pietroglyph/ferrofluid-display/README.md

# ferrofluid-display
Firmware, animation, and control code for a electromagnet-powered ferrofluid display.
