pietroglyph/ferrofluid-display/hardware/ecad/pcb-controller/pcb-controller.kicad_pcb

## KiCad design hardware/ecad/pcb-controller/pcb-controller.kicad_pcb (2021-11-19)

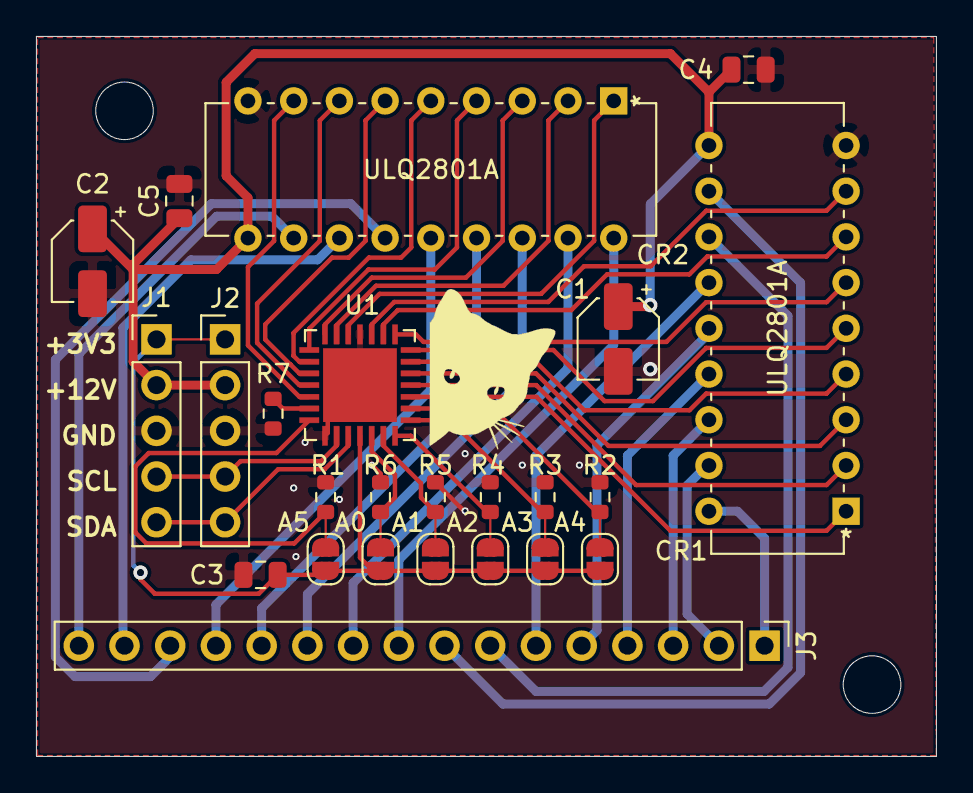
[picture p23: board pcb-controller.kicad_pcb from above]

Board: 2 copper layers, 50.0 x 40.0 mm, 26 parts (0 on the bottom side), 44 nets.

Parts:
A0, A1, A2, A3, A4, A5: SolderJumper_2_Open; SolderJumper-2_P1.3mm_Open_RoundedPad1.0x1.5mm
C1, C2: CP1; CP_Elec_4x5.4
C3, C4, C5: 0.1 uF; C_0805_2012Metric
CR1, CR2: ULQ2801A
H1, H2: MountingHole; MountingHole_3.2mm_M3
J1, J2: Conn_01x05; PinHeader_1x05_P2.54mm_Vertical
J3: Conn_01x16; PinHeader_1x16_P2.54mm_Vertical
R1, R2, R3, R4, R5, R6, R7: 10k; R_0603_1608Metric
U1: PCA9685BS; QFN65P600X600X100-29N

Connections:
+3V3: A0.1, A1.1, A2.1, A3.1, A4.1, A5.1, C3.1, J1.1, J2.1, U1.25
+12V: C1.1, C2.1, C4.1, C5.1, CR1.10, CR2.10, J1.2, J2.2
/A0: A0.2, R6.1, U1.26
/A1: A1.2, R5.1, U1.27
/A2: A2.2, R4.1, U1.28
/A3: A3.2, R3.1, U1.1
/A4: A4.2, R2.1, U1.2
/A5: A5.2, R1.1, U1.21
GND: C1.2, C2.2, C3.2, C4.2, C5.2, CR1.9, CR2.9, J1.3, J2.3, R1.2, R2.2, R3.2, R4.2, R5.2, R6.2, R7.2, U1.11, U1.22, U1.29
unnamed: CR1.1, U1.3
unnamed: CR1.2, U1.4
unnamed: CR1.3, U1.5
unnamed: CR1.4, U1.6
unnamed: CR1.5, U1.7
unnamed: CR1.6, U1.8
unnamed: CR1.7, U1.9
unnamed: CR1.8, U1.10
unnamed: CR1.11, J3.8
unnamed: CR1.12, J3.7
unnamed: CR1.13, J3.6
unnamed: CR1.14, J3.5
unnamed: CR1.15, J3.4
unnamed: CR1.16, J3.3
unnamed: CR1.17, J3.2
unnamed: CR1.18, J3.1
unnamed: CR2.1, U1.12
unnamed: CR2.2, U1.13
unnamed: CR2.3, U1.14
unnamed: CR2.4, U1.15
unnamed: CR2.5, U1.16
unnamed: CR2.6, U1.17
unnamed: CR2.7, U1.18
unnamed: CR2.8, U1.19
unnamed: CR2.11, J3.16
unnamed: CR2.12, J3.15
unnamed: CR2.13, J3.14
unnamed: CR2.14, J3.13
unnamed: CR2.15, J3.12
unnamed: CR2.16, J3.11
unnamed: CR2.17, J3.10
unnamed: CR2.18, J3.9
unnamed: J1.4, J2.4, U1.23
unnamed: J1.5, J2.5, U1.24
unnamed: R7.1, U1.20
