pietroglyph/ferrofluid-display/firmware/toggle_magnet/toggle_magnet.ino

// TO COMPILE:
// 1. Install avr_stl via the arduino IDE library manager
// 2. Go to Tools/Board/Boards Manager and set Arduino AVR version to 1.8.2
//    (See this thread on ArduinoSTL:
//    https://github.com/mike-matera/ArduinoSTL/issues/56
// 3. You need to increase SERIAL_RX_BUFFER_SIZE; because our file is
//    preprocessed in a way that adds #include <Arduino.h> at the start, any
//    definition of that macro will have no effect. You will need to edit
//    https://github.com/arduino/ArduinoCore-avr/blob/6154b7a7c1fba34737562aa4c29cec7451a82989/cores/arduino/HardwareSerial.h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
//    to use a buffer size of 256 manually.

#ifdef __AVR_ARCH__
#include "ArduinoSTL.h"
#endif

#include <cstddef>
#include <cstdint>

#include <algorithm>
#include <array>

#include <Arduino.h>
#ifdef __AVR_ARCH__
#undef min
#undef max
#endif

#include <Adafruit_PWMServoDriver.h>
#include <SdFat.h>

#ifdef __AVR_ARCH__
constexpr bool IS_TEENSY = false;
#else
constexpr bool IS_TEENSY = true;
#endif

constexpr std::uint8_t COLS_OF_BOARDS = 1, ROWS_OF_BOARDS = 1;
constexpr std::uint8_t NUM_BOARDS = COLS_OF_BOARDS * ROWS_OF_BOARDS;

constexpr std::uint8_t COLS_OF_MAGNETS = 4, ROWS_OF_MAGNETS = 4;
constexpr std::uint8_t NUM_MAGNETS_PER_BOARD =
    COLS_OF_MAGNETS * ROWS_OF_MAGNETS;
constexpr std::uint8_t NUM_MAGNETS = NUM_BOARDS * NUM_MAGNETS_PER_BOARD;

// Maxiumum magnet duty cycle; out of 4095 for the PCA
constexpr std::uint16_t MAX_DUTY_CYCLE = 4095;

// I^2C base address for boards (boards are assumed to be at addresses
// increasing sequentially from tihs address)
constexpr std::uint8_t BOARDS_ID_BASE = 0x42;

// CS pin for SD card reading on SPI
constexpr std::uint8_t CHIPSELECT_PIN = SS;

std::array<Adafruit_PWMServoDriver *, NUM_BOARDS> drivers;
SdFs sd;
FsFile animation_file;

void drive_output(std::uint8_t magnet_idx, std::uint16_t duty_cycle) {
  const std::uint8_t board_idx = magnet_idx / NUM_MAGNETS_PER_BOARD;
  // Need to subtract here because images start from top left indexes
  const std::uint8_t local_magnet_idx = magnet_idx % NUM_MAGNETS_PER_BOARD;

  // Serial.printf("Writing %d duty cycle to local magnet idx %d on board %d\n",
  // duty_cycle, local_magnet_idx, board_idx);

  drivers[board_idx]->setPin(local_magnet_idx, duty_cycle);
}

void drive_output(std::uint8_t x_coord, std::uint8_t y_coord,
                  std::uint16_t duty_cycle) {
  // Convert coordinate to board and magnet number
  // Assumes board 0 is in bottom left, and boards are
  // numbered going right and up (row major)
  const std::uint8_t board_x = x_coord / COLS_OF_MAGNETS;
  const std::uint8_t board_y = y_coord / ROWS_OF_MAGNETS;

  const std::uint8_t board_idx = board_x + board_y * COLS_OF_BOARDS;

  const std::uint8_t magnet_x = x_coord % COLS_OF_MAGNETS;
  const std::uint8_t magnet_y = y_coord % ROWS_OF_MAGNETS;

  const std::uint8_t magnet_idx = magnet_x + magnet_y * COLS_OF_MAGNETS;

  drivers[board_idx]->setPin(magnet_idx, duty_cycle);
}

// Returns true if the SD card is ok or false otherwise
bool try_open_sd() {
  if (!sd.sdErrorCode())
    return true;

  Serial.println(String("Opening SD card ") +
                 (IS_TEENSY ? "via SDIO" : "via SPI in Default mode"));
  bool ok;
  if constexpr (IS_TEENSY) {
    const SdSpiConfig spi_config{CHIPSELECT_PIN, DEDICATED_SPI, SPI_HALF_SPEED};
    ok = sd.begin(spi_config);
  } else {
    const auto sd_config = FIFO_SDIO;
    ok = sd.begin(sd_config);
  }
  if (!ok) {
    Serial.println("Failed to open SD card");
    return false;
  }
  return true;
}

class discrete_driver {
public:
  discrete_driver(unsigned long frame_period) : frame_period{frame_period} {}

  void set_magnet(std::uint8_t magnet_idx, std::uint16_t duty_cycle) {
    duty_cycles_current[magnet_idx] = duty_cycle;
  }

  bool ready_for_new_frame() { return ready_for_frame; }

  void update_display() {
    if (millis() - last_frame_time >= frame_period) {
      for (std::size_t i = 0; i < NUM_MAGNETS; i++) {
        drive_output(i, duty_cycles_current[i]);
      }

      ready_for_frame = true;
      last_frame_time = millis();
    } else
      ready_for_frame = false;
  }

protected:
  unsigned long frame_period;
  
  std::array<std::uint16_t, NUM_MAGNETS> duty_cycles_current{};
  unsigned long last_frame_time = 0;
  bool ready_for_frame = true;
};

class interpolating_driver : public discrete_driver {
public:
  interpolating_driver(unsigned long frame_period)
      : discrete_driver{frame_period} {}

  // User is expected to set all values, or array contents might be undefined or
  // previous values
  void set_magnet(std::uint8_t magnet_idx, std::uint16_t duty_cycle) {
    duty_cycles_next[magnet_idx] = duty_cycle;
  }

  bool ready_for_new_frame() { return ready_for_frame; }

  void update_display() {
    if (millis() - last_frame_time >= frame_period) {
      std::copy(duty_cycles_current.begin(), duty_cycles_current.end(),
                duty_cycles_last.begin());
      std::copy(duty_cycles_next.begin(), duty_cycles_next.end(),
                duty_cycles_current.begin());

      //        for (size_t i = 0; i < NUM_MAGNETS; i++) {
      //          Serial.printf("cur[%d]: %d, last[%d]: %d, next[%d]: %d\n", i,
      //          duty_cycles_current[i], i, duty_cycles_last[i], i,
      //          duty_cycles_next[i]);
      //        }

      ready_for_frame = true;
      last_frame_time = millis();
    } else {
      ready_for_frame = false;
    }

    for (std::size_t i = 0; i < NUM_MAGNETS; i++) {
      std::uint16_t slerped =
          duty_cycles_current[i] +
          std::max(static_cast<std::int32_t>(duty_cycles_last[i]) -
                       static_cast<std::int32_t>(duty_cycles_current[i]),
                   static_cast<std::int32_t>(0)) *
              (1.0 -
               static_cast<double>(millis() - last_frame_time) / frame_period);
      drive_output(i, slerped);
    }
  }

private:
  std::array<std::uint16_t, NUM_MAGNETS> duty_cycles_next{};
  std::array<std::uint16_t, NUM_MAGNETS> duty_cycles_last{};
};

enum control_mode {
  manual,
  sd_card,
  serial,
  off,
};
control_mode mode = control_mode::manual;
auto driver = interpolating_driver{1750};
boolean looping = false;

void setup() {
  Serial.begin(115200);

  Serial.println("Connecting to servo boards:");
  for (std::size_t i = 0; i < NUM_BOARDS; i++) {
    Serial.print("\tConnecting to board ");
    Serial.println(BOARDS_ID_BASE + i);
    drivers[i] = new Adafruit_PWMServoDriver(BOARDS_ID_BASE + i);
    drivers[i]->begin();
    drivers[i]->setOutputMode(true);
  }
  Serial.println("Servo boards connected");

  try_open_sd();
}

void loop() {
  if (Serial.available() && mode != control_mode::serial) {
    const auto command = Serial.readStringUntil(':');
    if (command == "XY") {
      mode = control_mode::manual;

      const int x = Serial.parseInt();
      Serial.find(',');
      const int y = Serial.parseInt();
      Serial.find(',');
      const int duty_cycle = Serial.parseInt();
      drive_output(x, y,
                   std::min(std::max(duty_cycle, 0),
                            static_cast<decltype(duty_cycle)>(MAX_DUTY_CYCLE)));

      Serial.println("Toggling magnet at position (" + (String)x + ", " + y +
                     "), with duty cycle " + duty_cycle);
    } else if (command == "IDX") {
      mode = control_mode::manual;

      const int idx = Serial.parseInt();
      Serial.find(',');
      const int duty_cycle = Serial.parseInt();

      drive_output(idx,
                   std::min(std::max(duty_cycle, 0),
                            static_cast<decltype(duty_cycle)>(MAX_DUTY_CYCLE)));
    } else if (command == "OFF") {
      mode = control_mode::off;
    } else if (command == "ls") {
      if (!try_open_sd()) {
        return;
      }
      sd.ls("/", LS_DATE | LS_SIZE | LS_R);
    } else if (command == "SD") {
      if (!try_open_sd()) {
        mode = control_mode::off;
        return;
      }

      mode = control_mode::sd_card;
      const String file_name = Serial.readStringUntil('\n');
      Serial.println("Opening file " + file_name);

      bool ok;
      if (!animation_file.open(file_name.c_str(), O_RDONLY)) {
        Serial.print("Failed to open file; failure code: ");
        sd.errorPrint(&Serial);
        Serial.println("\n Defaulting to first file on SD");
        
        FsFile root_dir;
        root_dir.open("/");
        ok = animation_file.openNext(&root_dir, O_RDONLY);
      }
      if (!ok) {
        Serial.println("Couldn't open file; does it exist?");
        mode = control_mode::off;
        return;
      }

      const int magnet_rows = animation_file.parseInt();
      if (animation_file.read() != ',') {
        Serial.println("Malformed separator");
        mode = control_mode::off;
        return;
      }
      const int magnet_cols = animation_file.parseInt();

      if (magnet_rows != ROWS_OF_MAGNETS || magnet_cols != COLS_OF_MAGNETS) {
        Serial.println("Mismatched number of magnets per row or column");
        mode = control_mode::off;
        return;
      }

      Serial.println("Running animation '" + file_name + "' for " +
                     magnet_cols + "x" + magnet_rows + " grid");
    } else if (command == "SER") {
      mode = control_mode::serial;
    } else if (command == "FT") {
      const int frame_period_new = Serial.parseInt();
      driver = interpolating_driver(frame_period_new);

      Serial.println("Setting frame period to " + (String) frame_period_new);
    } else {
      Serial.println("Unknown command");
    }
    Serial.find('\n'); // Eat a newline
  }

  if (mode == control_mode::sd_card || mode == control_mode::serial) {
    Stream *stream_to_use = mode == control_mode::sd_card
                                ? static_cast<Stream *>(&animation_file)
                                : static_cast<Stream *>(&Serial);

    std::uint8_t magnet_idx = 0;
    while (driver.ready_for_new_frame()) {
      const int duty_cycle = stream_to_use->parseInt();
      const char separator = stream_to_use->read();
      driver.set_magnet(
          magnet_idx++,
          std::min(std::max(duty_cycle, 0),
                   static_cast<decltype(duty_cycle)>(MAX_DUTY_CYCLE)));

      if (separator == ',')
        continue;
      else if (separator == '\n') {
        Serial.print("ack\n");
        break;
      } else if (separator == 0xFF) {
        // End of file (not actually the nbsp character)
        mode = control_mode::off;
        Serial.println("Animation done.");
        return;
      } else {
        Serial.print("Malformed separator ");
        Serial.println(separator);
        mode = control_mode::off;
        return;
      }
    }
    driver.update_display();
  } else if (mode == control_mode::off) {
    for (int i = 0; i < NUM_MAGNETS; i++) {
      drive_output(i, 0);
    }
    Serial.println("Turned magnets off");
    mode = control_mode::manual;
  }
}
