pietroglyph/ferrofluid-display/(commit log)

2021-11-06 Add hardware directory structure and pcb coil v1
    [PCB coil-B_Cu.gbr, PCB coil-Edge_Cuts.gbr, PCB coil-F_Cu.gbr, PCB coil-F_Mask.gbr, PCB coil-F_Paste.gbr, PCB coil-F_SilkS.gbr, PCB coil-In1_Cu.gbr, PCB coil-In2_Cu.gbr]
2021-11-08 Added controller design files. Need to add addresses.
    [pcb-controller.kicad_pcb, pcb-controller.sch]
2021-11-08 Added I2C headers and finished PCA9685 schematic wires.
    [pcb-controller.sch]
2021-11-14 Finished Rev 1 of controller pcb.
    [pcb-controller-B_Cu.gbr, pcb-controller-B_Mask.gbr, pcb-controller-B_Paste.gbr, pcb-controller-B_SilkS.gbr, pcb-controller-Edge_Cuts.gbr, pcb-controller-F_Cu.gbr, pcb-controller-F_Mask.gbr, pcb-controller-F_Paste.gbr]
2021-11-15 Switched to 16 pin header from 32 pin connector. Updated gerber.
    [pcb-controller-B_Cu.gbr, pcb-controller-B_Mask.gbr, pcb-controller-B_Paste.gbr, pcb-controller-B_SilkS.gbr, pcb-controller-Edge_Cuts.gbr, pcb-controller-F_Cu.gbr, pcb-controller-F_Mask.gbr, pcb-controller-F_Paste.gbr]
2021-11-18 Fix visual backend and add test images
    [animator.h]
2021-11-19 Fixed symbol libraries.
    [pcb-controller.kicad_pcb, pcb-controller.sch]
2021-12-02 Fix bugs with file backend
    [animator.h, main.cpp]
2021-12-03 Added Arduino firmware for turning magnets on/off based on coordinate
2021-12-10 Use correct max duty cycle instead of uint16 maximum
    [main.cpp, toggle_magnet.ino]
2021-12-11 Fix serial command parsing and add off command
    [toggle_magnet.ino]
2021-12-12 Add avr_stl so that we compile for AVR-based Arduinos
2021-12-12 Added Content to Magnets
2021-12-13 Added SPI sd-card reading for Arduinos
2021-12-13 Updated bits about the magnets
2021-12-14 Arduino firmware now attempts to open files by default, open first file as a fallback
2021-12-14 Added the ability to change frametime via serial command
2021-12-14 Edited systems page. Changes call to action button to systems.
